AscendedDaniel/clock/README.md

clock
=====

An open source hardware countdown clock.
