AscendedDaniel/clock/Enclosure/full_digit.png

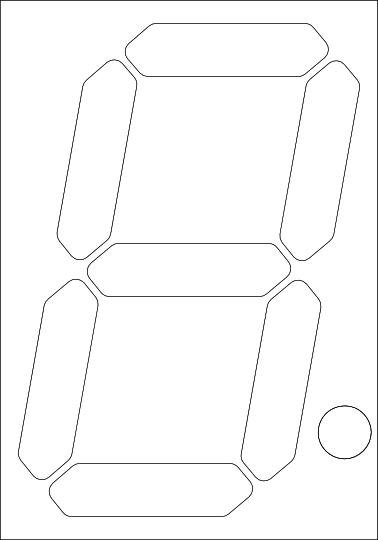
Enclosure/full_digit.png
