AscendedDaniel/clock/Enclosure/full_digit_labeled.png

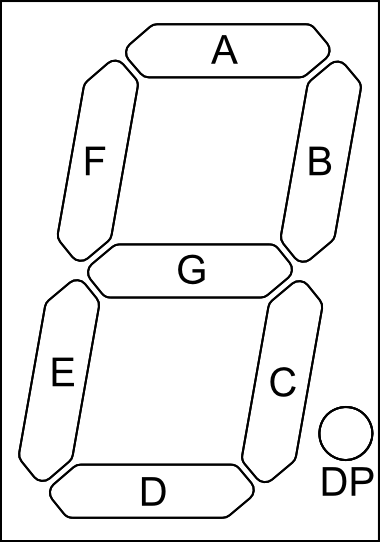
Enclosure/full_digit_labeled.png
