AscendedDaniel/clock/Enclosure/half_digit.png

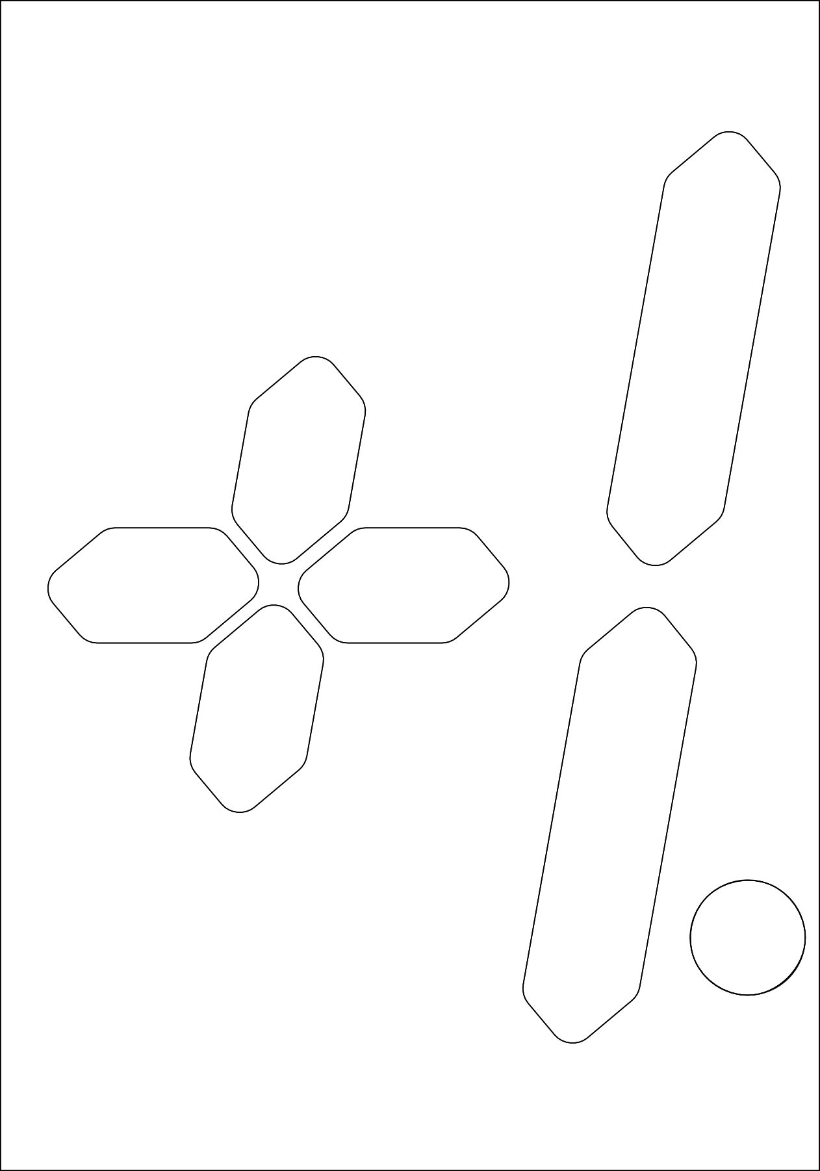
Enclosure/half_digit.png
