AscendedDaniel/clock/Enclosure/half_digit_labeled.png

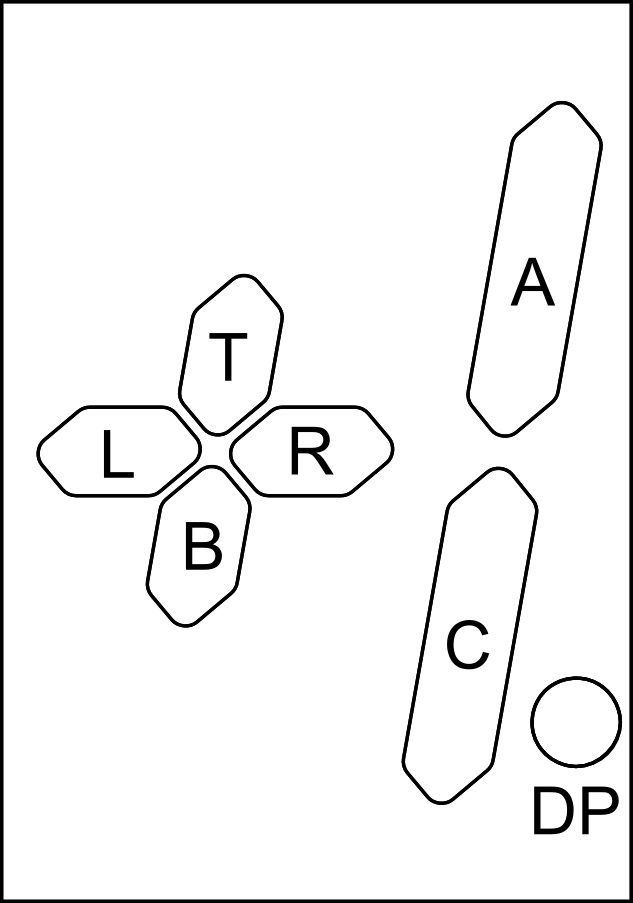
Enclosure/half_digit_labeled.png
