AscendedDaniel/clock/Kicad/full_digit/full_digit.png

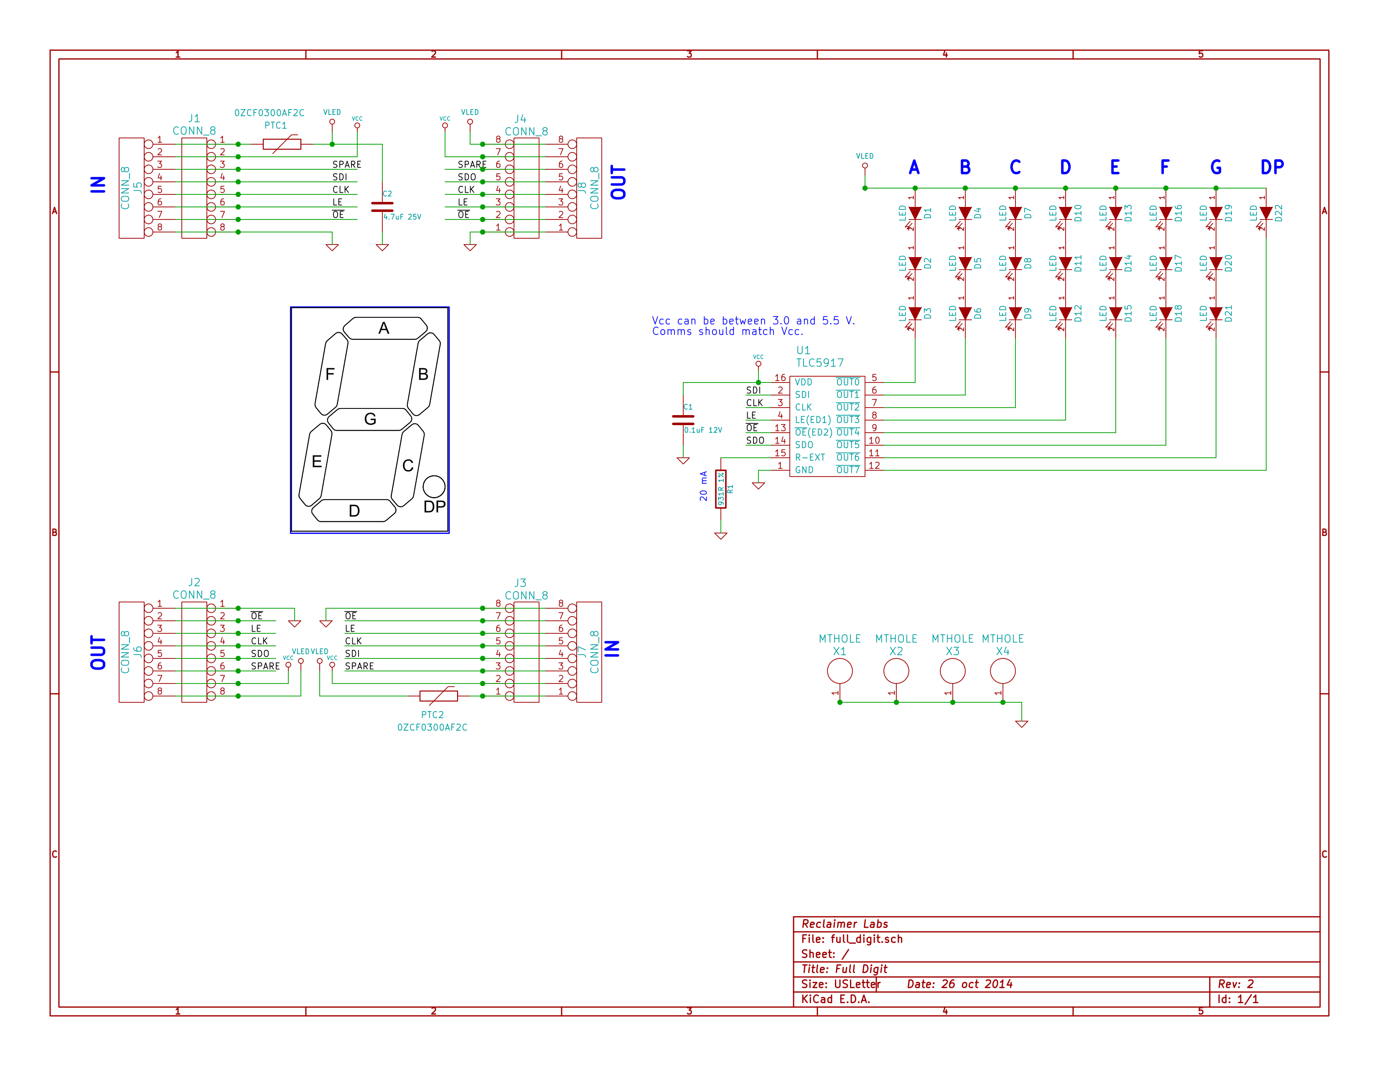
Kicad/full_digit/full_digit.png
