AscendedDaniel/clock/Kicad/full_digit/BOM.pdf

Reference | Quantity | Notes | Manufacturer | Manufacturer Part No | Distributer | Distributer's Part No
Interconnect | 2 | | Samtec | TSW-108-16-L-S
J1-J4 | 4 | | Samtec | SSM-108-L-SH
D1-D22 | 22 | | Lite-On | LTST-C230 | Digikey | 160-1889-1-ND
PTC1-PTC2 | 2 | Resettable fuse, 12+V, Ihold>3A, 2920 | Bel Fuse | 0ZCF0300AF2C | Digikey | 507-1753-1-ND
U1 | 1 | LED Driver with Shift Register Interface, TLC5916 can also wo | TI | TLC5917ID | Digikey | 296-21995-1-ND
R1 | 1 | resistor, 931R, 1%, 100ppm/C, 0603 | Rohm | MCR03ERTF9310 | Digikey | RHM931CFCT-ND
C1 | 1 | capacitor, ceramic, X5R/X7R, 0.1 uF, 50V, +/-20%, 0603 | Samsung | CL10B104KB8SFNC | Digikey | 1276-1936-1-ND
C2 | 1 | capacitor, ceramic, X5R/X7R, 4.7 uF, 50V, +/-20%, 0805 | Samsung | CL21A475KBQNNNE | Digikey | 1276-1248-1-ND
