AscendedDaniel/clock/gerber/full_digit_myro_BOM.xls

Reclaimer Labs, Full Digit
Qty | Part Reference | Part Number | MFGR | Digikey NO | DESCRIPTION | FOOTPRINT | DNI
1 | C1 | CL10B104KB8SFNC | Samsung | 1276-1936-1-ND | Capacitor, ceramic, X5R/X7R, 0.1 uF, 50 V, +/-20%, 0603 | 0603
1 | C2 | CL21A475KBQNNNE | Samsung | 1276-1248-1-ND | Capacitor, ceramic, X5R/X7R, 4.7 uF, 50 V, +/-20%, 0805 | 0805
4 | J1 J2 J3 J4 | SSM-108-F-SH | Samtec |  | Conn header 1x8 0.1 inch RA SMD | SMD 16 pins
1 | R1 | MCR03ERTF9310 | Rohm | RHM931CFCT-ND | Resistor, 931R, 1%, 100ppm/C, 0603 | 0603
1 | U1 | TLC5917ID | TI | 296-21995-1-ND | LED Driver with Shift Register Interface | 16-SOIC
22 | D1 D2 D3 D4 D5 D6 D7 D8 D9 D10 D11 D12 D13 D14 D15 D16 D17 D18 D19 D20 D21 D22 | LTST-C230KRKT | Lite-On | 160-1457-1-ND | LED 1206 SMD Reverse Mount, Red | 1206 Reverse Mount | See Note 1
22 | D1 D2 D3 D4 D5 D6 D7 D8 D9 D10 D11 D12 D13 D14 D15 D16 D17 D18 D19 D20 D21 D22 | LTST-C230KFKT | Lite-On | 160-2025-1-ND | LED 1206 SMD Reverse Mount, Orange | 1206 Reverse Mount | See Note 1
22 | D1 D2 D3 D4 D5 D6 D7 D8 D9 D10 D11 D12 D13 D14 D15 D16 D17 D18 D19 D20 D21 D22 | LTST-C230KSKT | Lite-On | 160-1458-1-ND | LED 1206 SMD Reverse Mount, Yellow | 1206 Reverse Mount | See Note 1
22 | D1 D2 D3 D4 D5 D6 D7 D8 D9 D10 D11 D12 D13 D14 D15 D16 D17 D18 D19 D20 D21 D22 | LTST-C230KGKT | Lite-On | 160-1456-1-ND | LED 1206 SMD Reverse Mount, Green | 1206 Reverse Mount | See Note 1
22 | D1 D2 D3 D4 D5 D6 D7 D8 D9 D10 D11 D12 D13 D14 D15 D16 D17 D18 D19 D20 D21 D22 | LTST-C230TBKT | Lite-On | 160-1889-1-ND | LED 1206 SMD Reverse Mount, Blue | 1206 Reverse Mount | See Note 1
1. Only install one part number of LED (lines 10-14) per board. See below for how many boards to stuff each color LED.
Line item to stuff | Number of Boards
10 | 8
11 | 8
12 | 8
13 | 12
14 | 14
2. Contact Jason Cerundolo (jason@reclaimerlabs.com) with any questions. Do not make substitutions without approval.
