AscendedDaniel/clock/gerber/full_digit_myro_Placement.xls

Reclaimer Labs
Jason Cerundolo
jason@reclaimerlabs.com
full_digit
2015-03-16
Reference | Value | Package | X Position [mm] | Y Position [mm] | Rotation [degrees] | Side
C1 | 0.1uF 12V | C_0603 | 1.95 | 4 | 270 | Top
C2 | 4.7uF 50V | C_0805 | 0.625 | 2.95 | 0 | Top
D1 | LED | 1206_LED_Reverse | 2.2705 | 5.4394 | 180 | Top
D2 | LED | 1206_LED_Reverse | 1.6799 | 5.4394 | 180 | Top
D3 | LED | 1206_LED_Reverse | 1.0894 | 5.4394 | 180 | Top
D4 | LED | 1206_LED_Reverse | 0.7559 | 3.6326 | 180 | Top
D5 | LED | 1206_LED_Reverse | 0.6534 | 4.2142 | 180 | Top
D6 | LED | 1206_LED_Reverse | 0.5509 | 4.7957 | 180 | Top
D7 | LED | 1206_LED_Reverse | 1.1781 | 1.1878 | 0 | Top
D8 | LED | 1206_LED_Reverse | 1.0752 | 1.7716 | 180 | Top
D9 | LED | 1206_LED_Reverse | 0.9722 | 2.3554 | 0 | Top
D10 | LED | 1206_LED_Reverse | 1.932 | 0.5533 | 0 | Top
D11 | LED | 1206_LED_Reverse | 2.5226 | 0.5533 | 0 | Top
D12 | LED | 1206_LED_Reverse | 3.1132 | 0.5533 | 0 | Top
D13 | LED | 1206_LED_Reverse | 3.6504 | 1.1984 | 180 | Top
D14 | LED | 1206_LED_Reverse | 3.5474 | 1.7822 | 180 | Top
D15 | LED | 1206_LED_Reverse | 3.4445 | 2.366 | 180 | Top
D16 | LED | 1206_LED_Reverse | 3.2282 | 3.6432 | 180 | Top
D17 | LED | 1206_LED_Reverse | 3.1256 | 4.2248 | 180 | Top
D18 | LED | 1206_LED_Reverse | 3.0231 | 4.8064 | 180 | Top
D19 | LED | 1206_LED_Reverse | 2.6906 | 3.0004 | 180 | Top
D20 | LED | 1206_LED_Reverse | 2.1 | 3.0004 | 180 | Top
D21 | LED | 1206_LED_Reverse | 1.5094 | 3.0004 | 180 | Top
D22 | LED | 1206_LED_Reverse | 0.368 | 1.1945 | 180 | Top
J1 | CONN_8 | SSM-SH-08 | 3.9 | 5.4 | 270 | Top
J2 | CONN_8 | SSM-SH-08 | 3.9 | 0.6 | 270 | Top
J3 | CONN_8 | SSM-SH-08 | 0.3 | 0.6 | 90 | Top
J4 | CONN_8 | SSM-SH-08 | 0.3 | 5.4 | 90 | Top
R1 | 931R 1% | C_0603 | 2.1 | 4.3 | 90 | Top
U1 | TLC5917 | SOIC16 | 2.225 | 4 | 90 | Top
