AscendedDaniel/clock/Enclosure/half_digit.FCStd

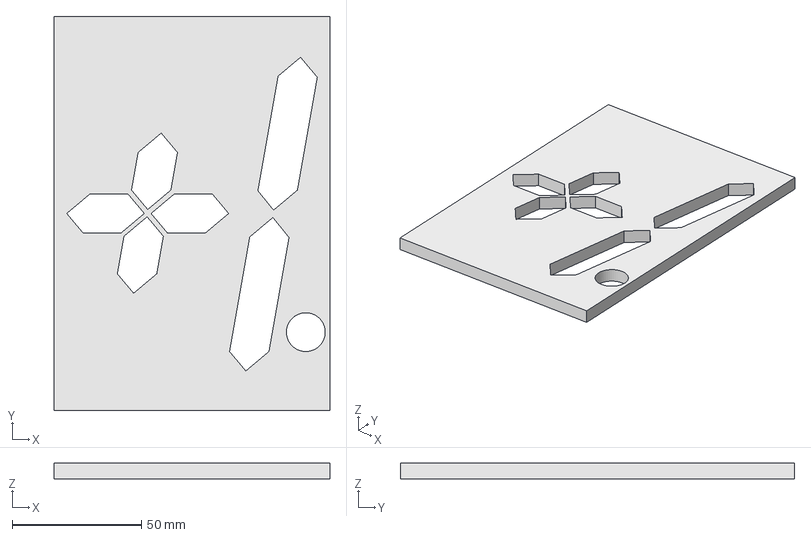
[picture p6: CAD file, 2014-11-25]
Enclosure/half_digit.FCStd
106.7 x 152.4 x 6.00 mm
