AscendedDaniel/clock/(list of files, cad)

Other CAD files:
Enclosure/full_digit.FCStd
Enclosure/full_digit.dxf
