AscendedDaniel/clock/(threads)

Thread 15 (2015-04-07):

Adjust LED Rotation

AscendedDaniel, 2015-04-07:
Fix LED rotation as per IPC standards. Currently the cathode is to the right. The cathode should be to the right as pin 1. See the screaming circuit blog for more information.
http://blog.screamingcircuits.com/2015/02/component-footprint-rotation.html

Closed 2015-05-08.

Thread 17 (2015-04-07):

Replace C2

AscendedDaniel, 2015-04-07:
Replace the 4.7 uF capacitor with a larger size if appropriate to reduce BOM cost.

Closed 2015-05-08.

Thread 18 (2015-04-24):

Fix spacing for Spark pinout

AscendedDaniel, 2015-04-24:
The Spark pinouts are too wide for the vertical mount.

Closed 2015-05-08.

Thread 19 (2015-04-24):

Arduino pads are too narrow

AscendedDaniel, 2015-04-24:

Closed 2015-05-08.

Thread 20 (2015-04-30):

Shunt and sleeve swapped on power barrel connector

AscendedDaniel, 2015-04-30:

Closed 2015-05-08.

Thread 22 (2015-05-08):

LED pad placement

AscendedDaniel, 2015-05-08:
Update pad placement for LEDs to ensure a good connection on both pins. In preproduction, there was an occasional failure of the soldering where one pad pulled the LED out of reach of the other pad. Recommend narrowing the NPTH slot, narrowing the copper pads, and bringing the copper pads closer together.
