AscendedDaniel/clock/Kicad/full_digit/full_digit.pdf

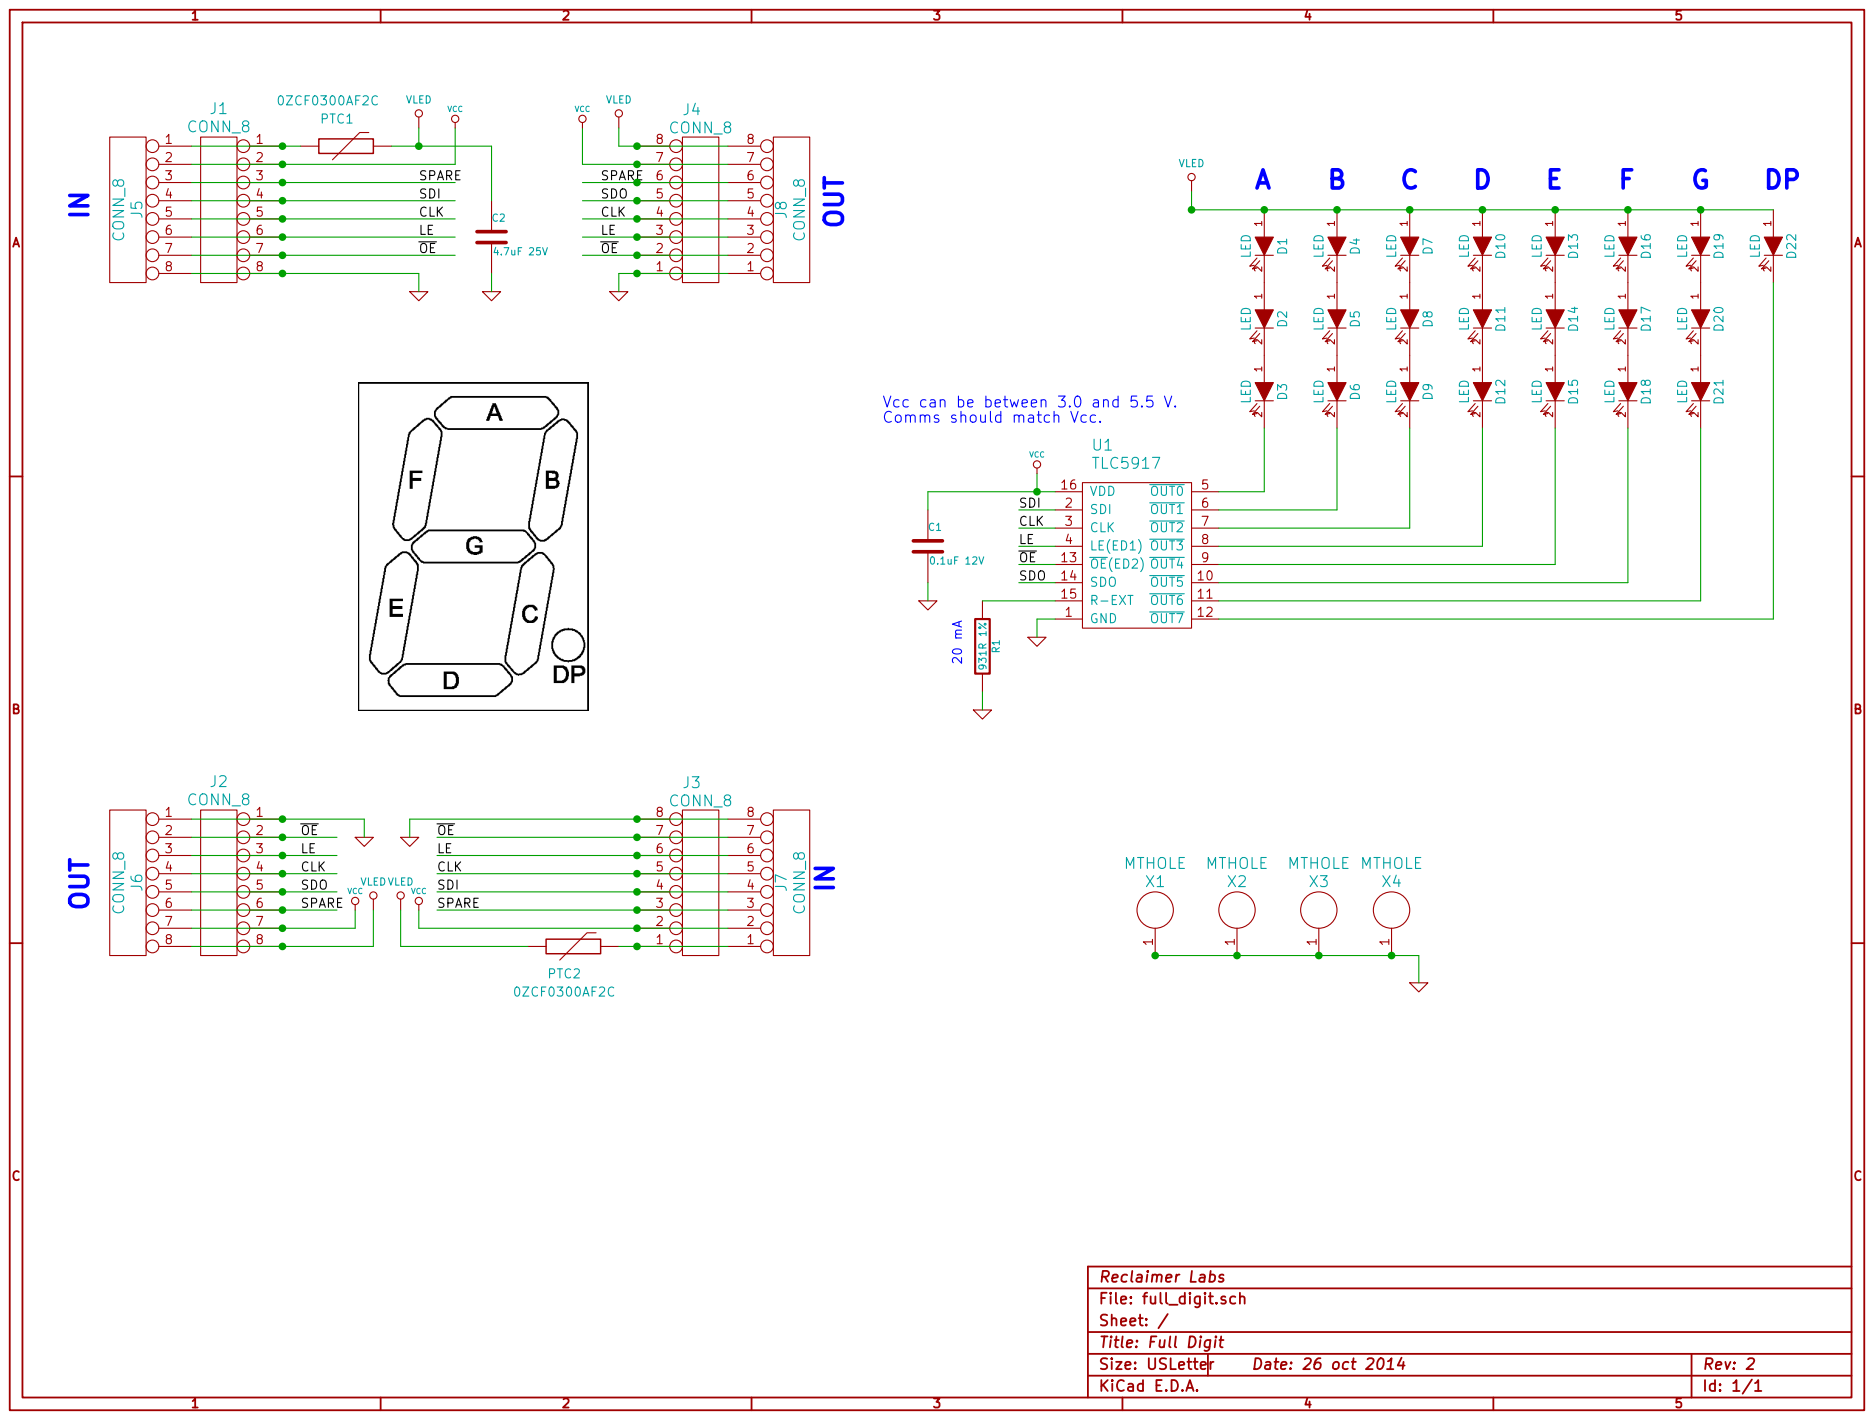
[picture p7: page 1]
