AscendedDaniel/clock/Kicad/half_digit/half_digit.pdf

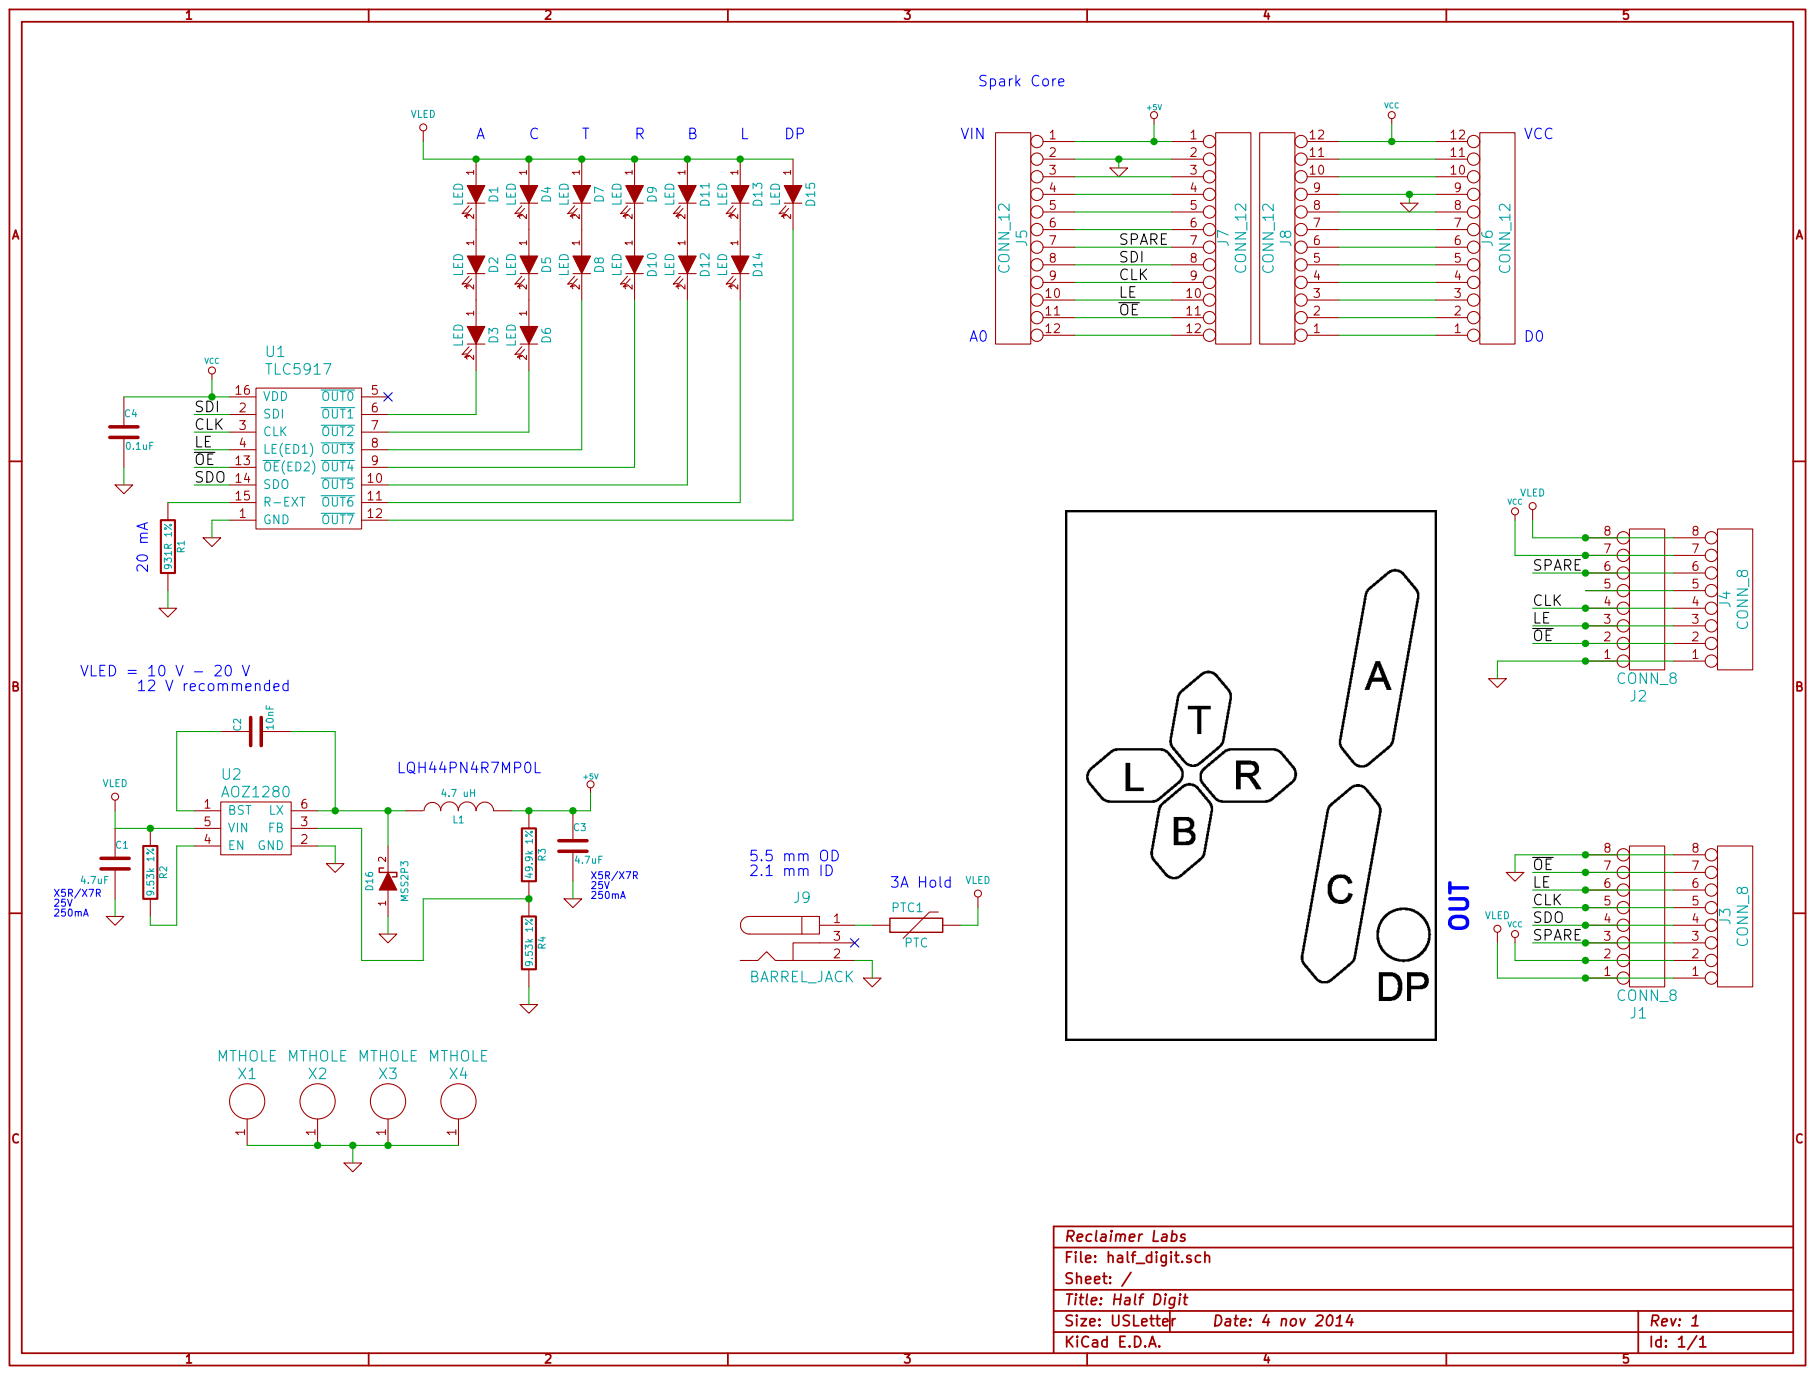
[picture p8: page 1]
