AscendedDaniel/clock/Kicad/full_digit/full_digit.kicad_pcb

## KiCad design Kicad/full_digit/full_digit.kicad_pcb (2015-05-08)

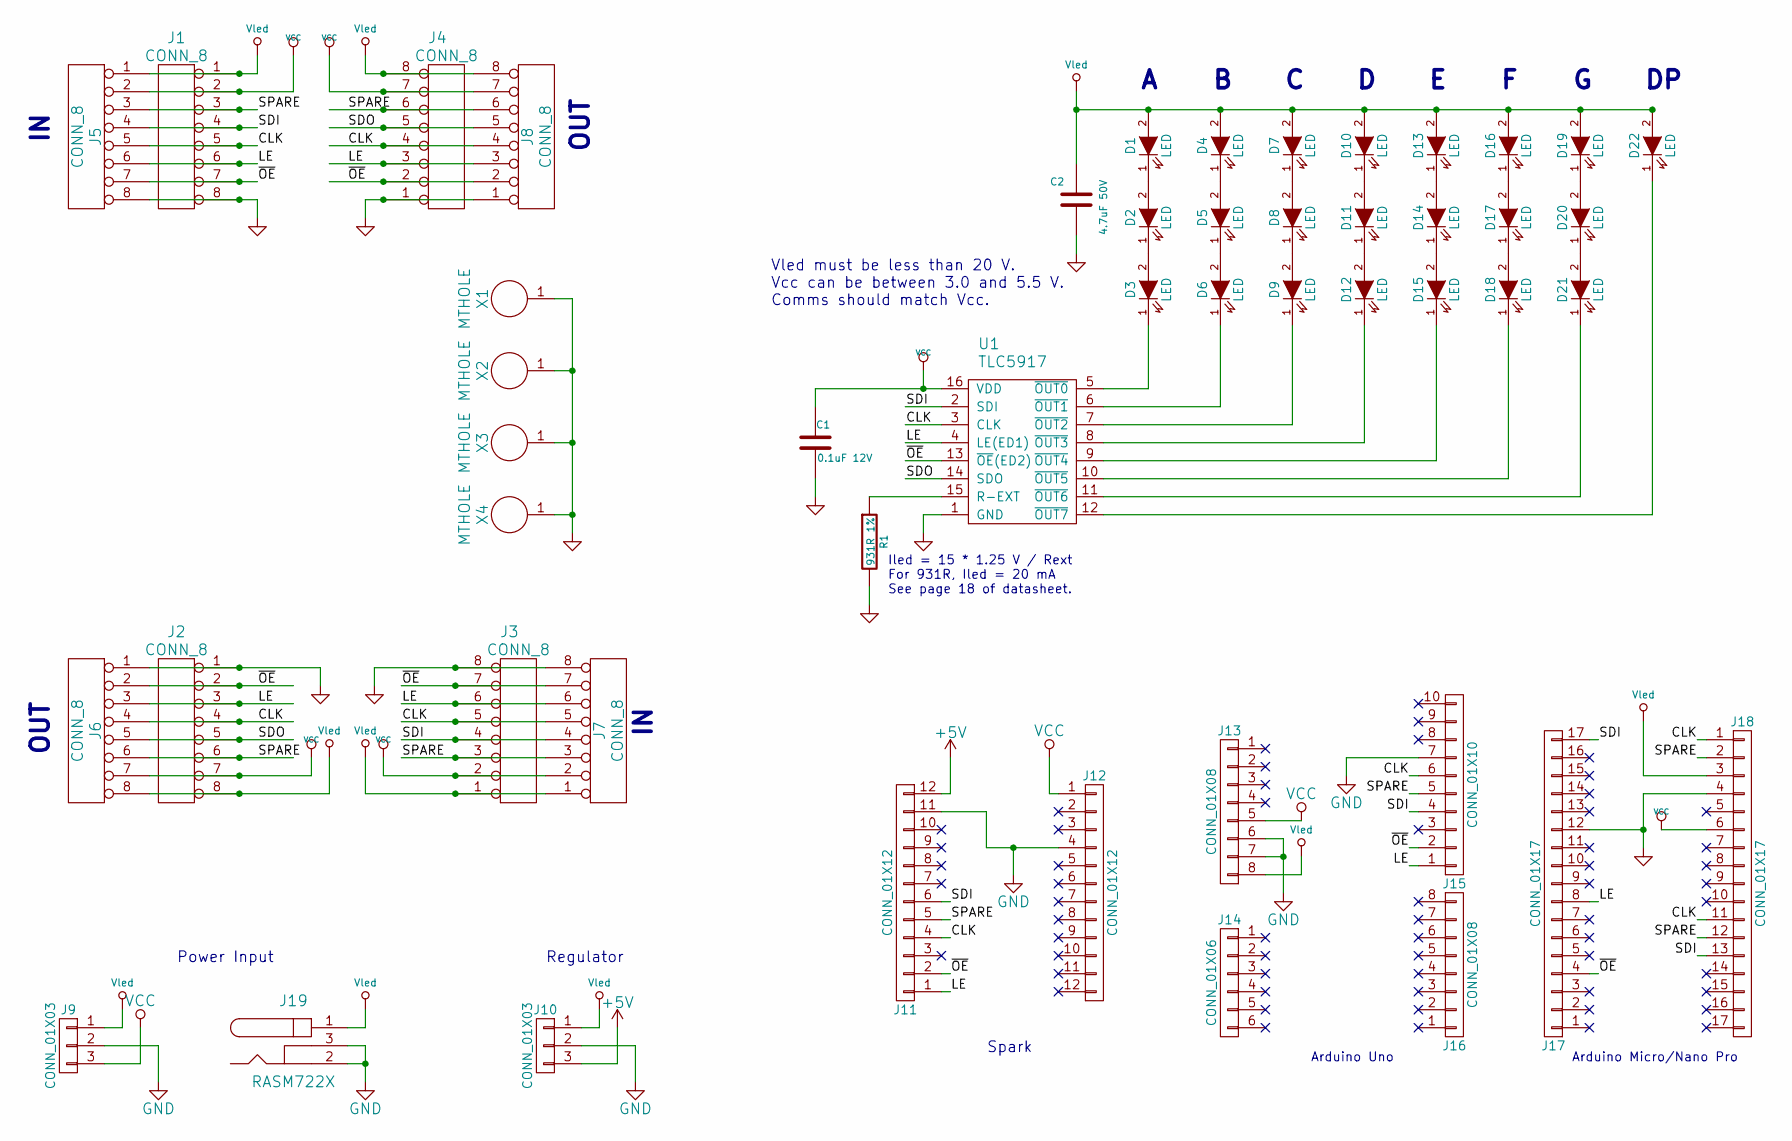
[picture p9: schematic full_digit.sch, Full Digit Seven Segment Display]

Parts:
C1: 0.1uF 12V; C_0603
C2: 4.7uF 50V; C_1206_HandSoldering
D1, D2, D3, D4, D5, D6, D7, D8, D9, D10, D11, D12, D13, D14, D15, D16, D17, D18, D19, D20, D21, D22: LED; 1206_LED_Reverse
J1, J2, J3, J4: CONN_8; SSM-SH-08
J5, J6, J7, J8: CONN_8; HEADER_8X1
J9, J10: CONN_01X03; HEADER_SMT_01x03
J11, J12: CONN_01X12; HEADER_SMT_01x12_SV
J13, J16: CONN_01X08; HEADER_SMT_01x08
J14: CONN_01X06; HEADER_SMT_01x06
J15: CONN_01X10; HEADER_SMT_01x10
J17, J18: CONN_01X17; HEADER_SMT_01x17
J19: RASM722X; RASM722
R1: 931R 1%; C_0603
U1: TLC5917; SOIC16_Jason
X1, X2, X3, X4: MTHOLE; MTHOLE_3mm

Connections:
+5V: J10.3, J11.12
/CLK: J1.5, J2.4, J3.5, J4.4, J5.5, J6.4, J7.5, J8.4, J11.4, J15.6, J18.1, J18.11, U1.3 (CLK)
/LE: J1.6, J2.3, J3.6, J4.3, J5.6, J6.3, J7.6, J8.3, J11.1, J15.1, J17.8, U1.4 (LE(ED1))
/SDI: J1.4, J3.4, J5.4, J7.4, J11.6, J15.4, J17.17, J18.13, U1.2 (SDI)
/SDO: J2.5, J4.5, J6.5, J8.5, U1.14 (SDO)
/SPARE: J1.3, J2.6, J3.3, J4.6, J5.3, J6.6, J7.3, J8.6, J11.5, J15.5, J18.2, J18.12
/~OE: J1.7, J2.2, J3.7, J4.2, J5.7, J6.2, J7.7, J8.2, J11.2, J15.2, J17.4, U1.13 (~OE~(ED2))
GND: C1.2, C2.2, J1.8, J2.1, J3.8, J4.1, J5.8, J6.1, J7.8, J8.1, J9.2, J10.2, J11.11, J12.4, J13.6, J13.7, J15.7, J17.12, J18.4, J19.2, J19.3, R1.2, U1.1 (GND), X1.1, X2.1, X3.1, X4.1
unnamed: D1.1 (K), D2.2 (A)
unnamed: D2.1 (K), D3.2 (A)
unnamed: D3.1 (K), U1.5 (~OUT0)
unnamed: D4.1 (K), D5.2 (A)
unnamed: D5.1 (K), D6.2 (A)
unnamed: D6.1 (K), U1.6 (~OUT1)
unnamed: D7.1 (K), D8.2 (A)
unnamed: D8.1 (K), D9.2 (A)
unnamed: D9.1 (K), U1.7 (~OUT2)
unnamed: D10.1 (K), D11.2 (A)
unnamed: D11.1 (K), D12.2 (A)
unnamed: D12.1 (K), U1.8 (~OUT3)
unnamed: D13.1 (K), D14.2 (A)
unnamed: D14.1 (K), D15.2 (A)
unnamed: D15.1 (K), U1.9 (~OUT4)
unnamed: D16.1 (K), D17.2 (A)
unnamed: D17.1 (K), D18.2 (A)
unnamed: D18.1 (K), U1.10 (~OUT5)
unnamed: D19.1 (K), D20.2 (A)
unnamed: D20.1 (K), D21.2 (A)
unnamed: D21.1 (K), U1.11 (~OUT6)
unnamed: D22.1 (K), U1.12 (~OUT7)
unnamed: R1.1, U1.15 (R-EXT)
VCC: C1.1, J1.2, J2.7, J3.2, J4.7, J5.2, J6.7, J7.2, J8.7, J9.3, J12.1, J13.5, J18.6, U1.16 (VDD)
Vled: C2.1, D1.2 (A), D4.2 (A), D7.2 (A), D10.2 (A), D13.2 (A), D16.2 (A), D19.2 (A), D22.2 (A), J1.1, J2.8, J3.1, J4.8, J5.1, J6.8, J7.1, J8.8, J9.1, J10.1, J13.8, J18.3, J19.1

Notes on the sheet:
OUT
Iled = 15 * 1.25 V / Rext For 931R, Iled = 20 mA See page 18 of datasheet.
Vled must be less than 20 V. Vcc can be between 3.0 and 5.5 V. Comms should match Vcc.
Spark
Regulator
Arduino Uno
Arduino Micro/Nano Pro
Power Input

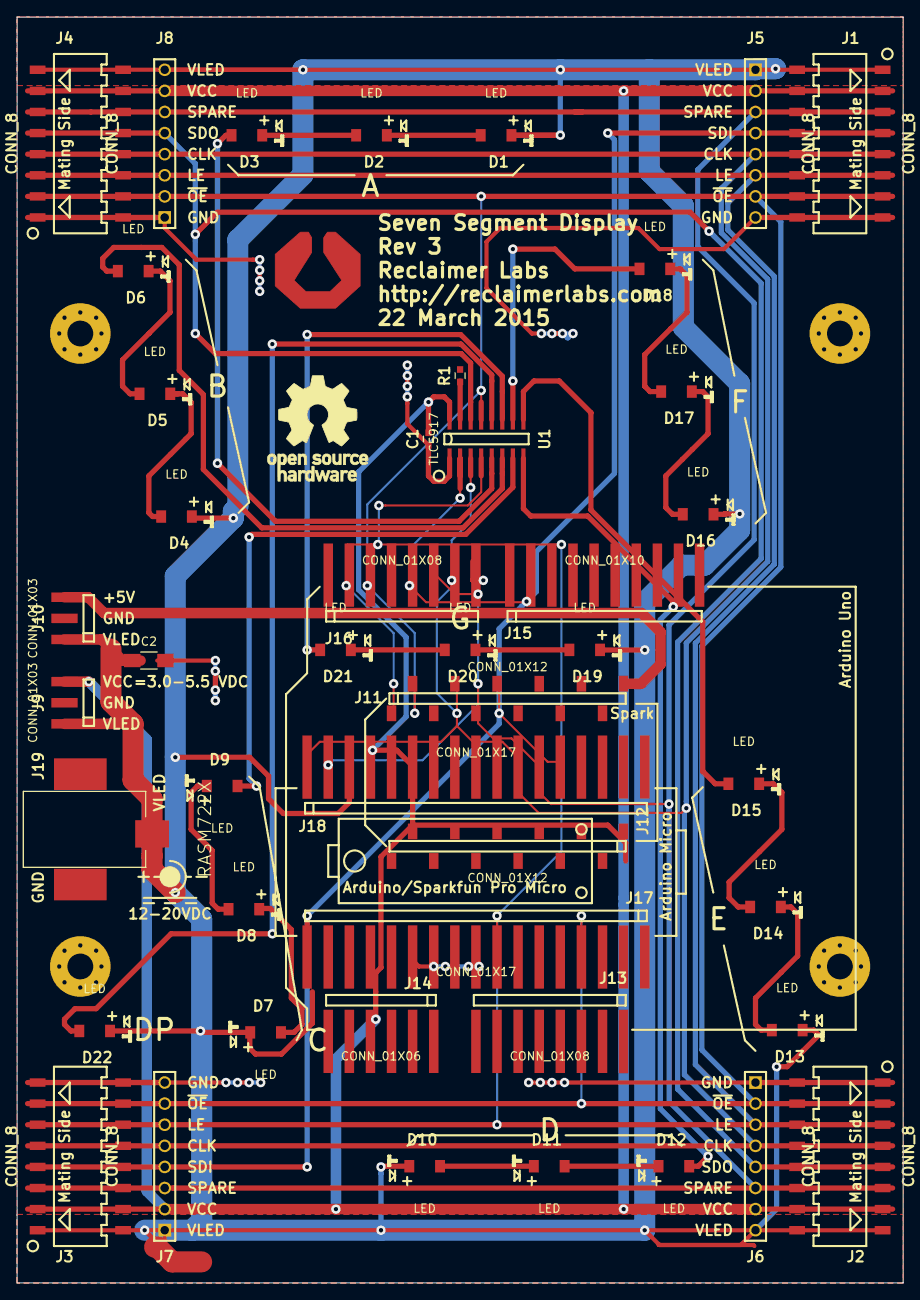
[picture p10: board full_digit.kicad_pcb from above]

Board: 2 copper layers, 106.7 x 152.4 mm, 49 parts (0 on the bottom side), 33 nets.
