AscendedDaniel/clock/Kicad/half_digit/half_digit.kicad_pcb

## KiCad design Kicad/half_digit/half_digit.kicad_pcb (2014-12-13)

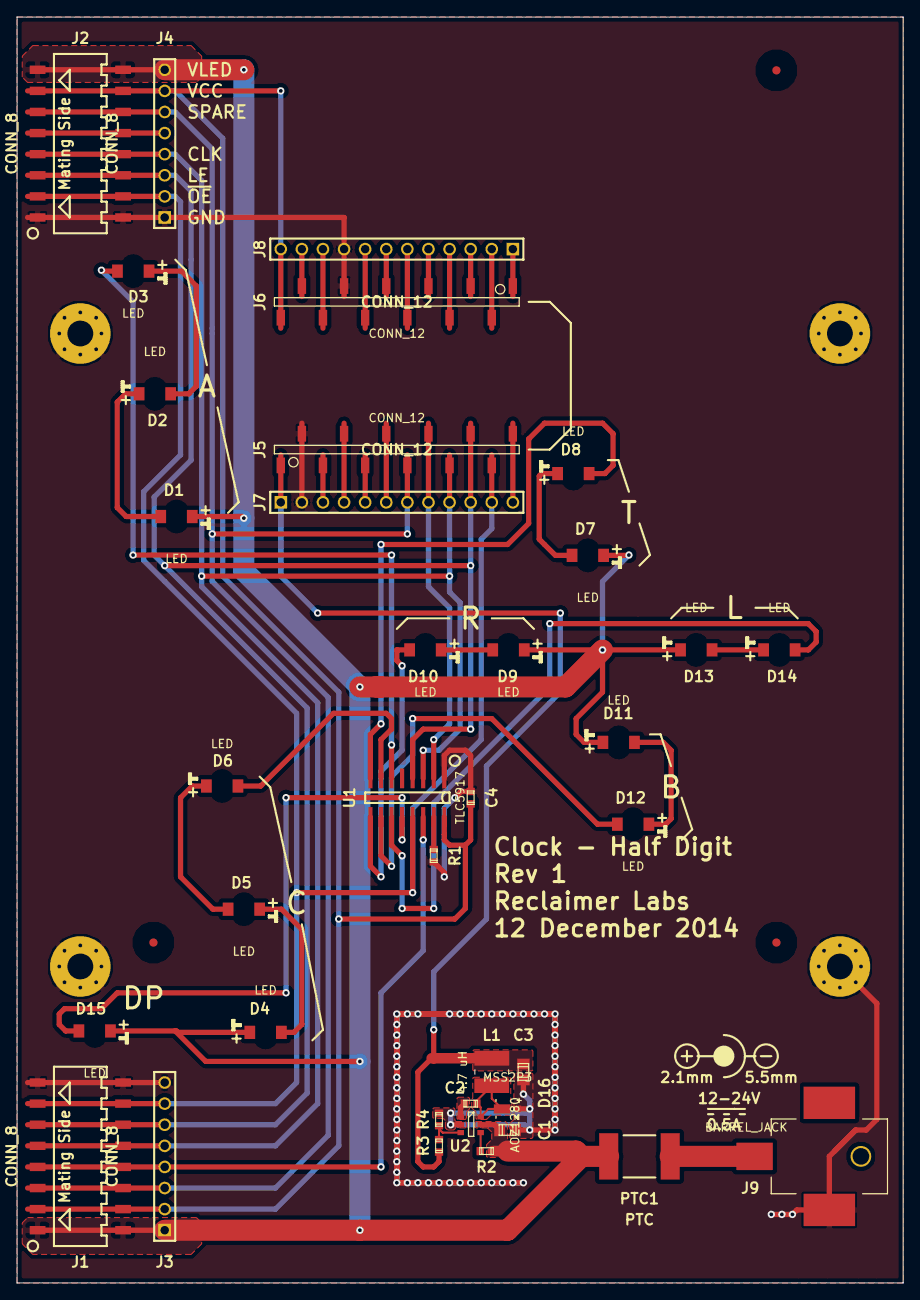
[picture p11: board half_digit.kicad_pcb from above]

Board: 2 copper layers, 106.7 x 152.4 mm, 44 parts (0 on the bottom side), 47 nets.

Parts:
C1, C3: 4.7uF; c_0805
C2: 10nF; c_0603
C4: 0.1uF; c_0603
D1, D2, D3, D4, D5, D6, D7, D8, D9, D10, D11, D12, D13, D14, D15: LED; 1206_LED_Reverse
D16: MSS2P3
FIDUCIAL: VAL**; FIDUCIAL
FIDUCIAL#2, FIDUCIAL#3: VAL**; FIDUCIAL
J1, J2: CONN_8; SSM-SH-08
J3, J4: CONN_8; HEADER_8X1
J5, J6: CONN_12; SSM-SV-12
J7, J8: CONN_12; HEADER_12X1
J9: BARREL_JACK; PJ-036AH-SMT
L1: 4.7 uH; 1515
PTC1: PTC; 2920_ptc
R1: 931R 1%; c_0603
R2, R4: 9.53k 1%; c_0603
R3: 49.9k 1%; c_0603
U1: TLC5917; SOIC16_Jason
U2: AOZ1280; SOT23_6_Jason
X1, X2, X3, X4: MTHOLE; MTHOLE_3mm

Connections:
+5V: C3.1, J5.1, J7.1, L1.2, R3.1
/CLK: J1.5, J2.4, J3.5, J4.4, J5.9, J7.9, U1.3
/LE: J1.6, J2.3, J3.6, J4.3, J5.10, J7.10, U1.4
/SDI: J5.8, J7.8, U1.2
/SDO: J1.4, J3.4, U1.14
/SPARE: J1.3, J2.6, J3.3, J4.6, J5.7, J7.7
/~OE: J1.7, J2.2, J3.7, J4.2, J5.11, J7.11, U1.13
GND: C1.2, C3.2, C4.2, D16.1, J1.8, J2.1, J3.8, J4.1, J5.2, J6.9, J7.2, J8.9, J9.2, R1.2, R4.2, U1.1, U2.2, X1.1, X2.1, X3.1, X4.1
unnamed: D15.2, U1.12
unnamed: D14.2, U1.11
unnamed: D12.2, U1.10
unnamed: D10.2, U1.9
unnamed: D8.2, U1.8
unnamed: D6.2, U1.7
unnamed: D3.2, U1.6
unnamed: R1.1, U1.15
unnamed: J5.5, J7.5
unnamed: J5.4, J7.4
unnamed: J5.3, J7.3
unnamed: J5.6, J7.6
unnamed: J6.5, J8.5
unnamed: J9.1, PTC1.1
unnamed: J6.11, J8.11
unnamed: J6.10, J8.10
unnamed: J6.8, J8.8
unnamed: J6.7, J8.7
unnamed: J6.6, J8.6
unnamed: J6.4, J8.4
unnamed: J6.3, J8.3
unnamed: J6.2, J8.2
unnamed: J6.1, J8.1
unnamed: J5.12, J7.12
unnamed: R3.2, R4.1, U2.3
unnamed: J2.5, J4.5
unnamed: C2.2, D16.2, L1.1, U2.6
unnamed: C2.1, U2.1
unnamed: R2.2, U2.4
unnamed: D5.2, D6.1
unnamed: D4.2, D5.1
unnamed: D9.2, D10.1
unnamed: D13.2, D14.1
unnamed: D7.2, D8.1
unnamed: D11.2, D12.1
unnamed: D2.2, D3.1
unnamed: D1.2, D2.1
VCC: C4.1, J1.2, J2.7, J3.2, J4.7, J6.12, J8.12, U1.16
Vled: C1.1, D1.1, D4.1, D7.1, D9.1, D11.1, D13.1, D15.1, J1.1, J2.8, J3.1, J4.8, PTC1.2, R2.1, U2.5
