AscendedDaniel/clock/(commit log)

2014-10-15 Initial Commit
    Initial commit of Kicad files, including project, schematic, board, and
    project-specific library.
    [full_digit.kicad_pcb, full_digit.sch]
2014-10-18 Updated Schematic PDF
2014-10-18 Initial Commit of Test Firmware
    Added two firmware files for Arduino to test seven segment panels.
2014-10-19 Adding BoM
    Initial commit of Bill of Materials for Rev 1 hardware.
2014-10-19 Fix Inter-board Connector
    This fixes the inter-board connector polarity issue (#2) in the
    schematic.
    [full_digit.sch]
2014-10-19 +5V to Vcc
    Fix for Issue +13 in schematic.
    [full_digit.sch]
2014-10-19 Added fuses
    Added two PTC resettable fuses, one to each input terminal. This
    resolves issue #3. The extra resistance is a maximum of 50 mOhm per PTC
    under normal conditions. This reduces the maximum number of series
    panels from 25 to 17 between additional power connectors are needed. The
    trip current is 3 A.
    [full_digit.sch]
2014-10-21 Updated Decoupling Capacitors
    Updated the decoupling capacitors and consolidated C2-C5 into C2. One
    4.7uF cap should be enough to ensure that the voltage drop resulting
    from all segments off to all segments on remains less than 1 V while the
    power supply compensates. C1 decouples U1, which has a maximum clock
    frequency of 30 MHz, but will be operating well under that for most
    applications. One standard 0.1uF cap on the Vcc rail should be enough.
    [full_digit.sch]
2014-10-21 Updated Footprints for Rev 2
    [full_digit.sch]
2014-10-21 Rev 2 Layout Start
    U1 is rotated as per issue #6. Mounting holes have been moved as per
    issue #8.
2014-10-24 Mechanical and Logo Updates
    Updated Reclaimer Labs Logo as per issue #11. Also added thru-hole
    connectors to layout as per issue #9. Mounting holes have been moved as
    per issue #8. LED hole is replaced with slot as per issue #7, might need
    to be tweaked to reduce rotation during assembly. Inter-board connector
    silkscreen is updated to more easily show mating side vs non-mating side
    as per issue #5. Initial commit of gerbers.
    [full_digit-B_Cu.gbl, full_digit-B_Mask.gbs, full_digit-Dwgs_User.gbr, full_digit-Edge_Cuts.gbr, full_digit-F_Cu.gtl, full_digit-F_Mask.gts, full_digit-F_Paste.gtp, full_digit-F_SilkS.gto]
2014-10-26 Added pin labels
    Added labels on all input and output pins as per issue #5.
    [full_digit-B_Cu.gbl, full_digit-B_Mask.gbs, full_digit-Dwgs_User.gbr, full_digit-Edge_Cuts.gbr, full_digit-F_Cu.gtl, full_digit-F_Mask.gts, full_digit-F_Paste.gtp, full_digit-F_SilkS.gto]
2014-10-26 Removed test points
    Removed test points T0-T7. They are unnecessary, as the pins on U1 and
    the LEDs provide a good enough interface. If they are needed for
    pogo-pin type testing, they can be added back in.
    [full_digit.kicad_pcb]
2014-10-26 Rev 2 Feature Complete
    Possible final draft of Rev 2 layout.
    [$full_digit.sch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]
2014-10-27 Layout Tweaks
    Updated silkscreen to include voltage ranges. Updated tracks into all
    parts to balance and center tracks in and out.
    [full_digit-B_Cu.gbl, full_digit-B_Mask.gbs, full_digit-Dwgs_User.gbr, full_digit-Edge_Cuts.gbr, full_digit-F_Cu.gtl, full_digit-F_Mask.gts, full_digit-F_Paste.gtp, full_digit-F_SilkS.gto]
2014-10-27 Gerber packing
    Packing two version of the gerbers. One for more full-service
    manufactures with assembly drawings, notes, and maps. The other is the
    RS274X gerbers for more automated manufacturers.
    [full_digit.kicad_pcb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]
2014-11-02 Initial Commit of Half Digit
    Organized the folders and added the schematic for the half digit.
    [full_digit.kicad_pcb, full_digit.sch, half_digit.sch]
2014-11-03 Partial Layout
    LEDs, inter-board connectors, and buck converter placed. Still need to
    figure out placement of DC jack.
    [.kicad_pcb.kicad_pcb, full_digit.kicad_pcb, half_digit.kicad_pcb, half_digit.sch]
2014-11-05 Rough draft of half digit layout
    [half_digit-B_Cu.gbl, half_digit-B_Mask.gbs, half_digit-Dwgs_User.gbr, half_digit-Edge_Cuts.gbr, half_digit-F_Cu.gtl, half_digit-F_Mask.gts, half_digit-F_Paste.gtp, half_digit-F_SilkS.gto]
2014-11-25 Initial Check-in of Enclosure
    [full_digit.FCStd, full_digit.dxf, half_digit.FCStd, half_digit.kicad_pcb]
2014-12-13 Half Digit Work
    Moved spark landing pads to not interfere with L-bracket from OpenBeam
    frame.
    [half_digit.kicad_pcb, half_digit.sch]
2015-03-03 Added new connectors to schematics
    Added DNS connectors for Spark Core/Photon/Electron, Arduino
    Uno/Micro/Nano. Also redacted access token for the Spark Core used for
    the prototype clock. That Spark has been destroyed, so don't bother
    trying to use the token.
    [full_digit.sch]
2015-03-14 Placement of Rev 3
    Placed new parts: Spark, Arduino Uno, Arduino Micro, and logo. Routing
    still to do.
    [full_digit.kicad_pcb, full_digit.sch]
2015-03-25 Rev 3 Final Draft
    [full_digit-B_Cu.gbl, full_digit-B_Mask.gbs, full_digit-Dwgs_User.gbr, full_digit-Edge_Cuts.gbr, full_digit-F_Cu.gtl, full_digit-F_Mask.gts, full_digit-F_Paste.gtp, full_digit-F_SilkS.gto]
2015-05-04 Firmware Updates
    Updated firmware to be consistent with the Rev 3 built-in pads for
    Arduino and Spark.
    [full_digit.csv, full_digit.kicad_pcb, full_digit_myro_BOM.xls, full_digit_myro_Placement.xls]
2015-05-08 First Rev 4 fixes
    * Added NPTH for barrel connector as per issue #21
    * Connected shunt and sleeve together to increase chances of capability
    with barrel connectors as per issue #20
    * Lengthen Arduino pads and double-checked spacing as per issue #19
    * Fixed spacing for Spark Cores as per issue #18
    * Updated C2 to 1206 as per issue #17
    * Fixed LED library to match rotation to IPC spec as per issue #15
    [full_digit.sch]
2015-05-08 Updated controller pads
    [full_digit.kicad_pcb]
